jmolinaroli/eRumby-Car/README.md

#eRumby-Car
 
The eRumby is an autonomous RC electric vehicle based on the Kyosho INFERNO VE Race car.

Objects of this study:
* definition of: 
	- hardware architecture; 
	- software architecture;
* calibration of the sensors;
* development of an obstacle
* avoidance algorithm.

![alt tag] (https://github.com/jmolinaroli/eRumby-Car/blob/master/Models/Img/boards_model.png)
