jmolinaroli/eRumby-Car/ArduinoMega-Radio-Motors-IMU/README.md

#ARDUINO MEGA RADIO-MOTORS CONTROLLER

The Arduino Mega receives the control input from the Radio Receiver, sends input to control Traction and Stearing Motors and elaborates the data from the IMU board.

![alt tag] (https://github.com/jmolinaroli/eRumby-Car/blob/master/Models/Img/radio-motors_model.png)
