jmolinaroli/eRumby-Car/ArduinoMega-Radio-Motors/README.md

#ARDUINO MEGA RADIO-MOTORS CONTROLLER

![alt tag] (https://github.com/jmolinaroli/eRumby-Car/blob/master/Img/radio-motors_model.png)
