jmolinaroli/eRumby-Car/(commit log)

2016-11-10 drawing IMU data in 2D
2016-11-10 drawing IMU data in 3D
2016-11-10 only print roll pitch yaw angle
2016-11-10 Radio-Motors code review
2016-11-10 IMu on ArduinoMega
    merging the codes
2016-11-11 IMU data viewer
2016-11-11 ArduinoMega model upload
2016-11-11 ArduinoMega code review
2016-11-11 ArduinoMega code
2016-11-15 Arduino Mega code
    Receivere + Stearing Motor + Traction Motor + Encoder Master
2016-11-23 Arduino Mega code update
2016-11-23 IMU update
2016-12-05 Encoders Reader
2016-12-13 OLD code Arduino Mega
2016-12-13 Encoders Master - Slave
2016-12-15 Encoder Ricevente
